clovislaforet/Station-telemetrique/README.md

# Station télémétrique
*Projet de station de télémétrie longue portée utilisant des modules LoRa pour transmettre des données entre un système embarqué (type avion RC) et une station sol.*



Vous trouverez ci-dessous quelques informations générales relatives au projet, mais un rapport complet et précis de celui-ci est disponible au téléchargement sous le nom "Rapport - Station télémétrique.pdf".

## État du projet
***Le prototype final du système est fonctionnel, et a été intégré avec succès à un aéromodèle !***

## Matériel
- Microcontroleurs : Arduino Nano Every et Arduino Mega 2560
- Module caméra : ESP32-S3 IA Camera
- Antennes longue portée : 2 modules LoRa SX1278 434mHz
- GPS : U-blox NEO-7M
- Capteur de température, d'humidité et de pression : BME280
- UBEC 5V 3A et convertisseur de tension DC-DC 5V-3.3V

<table align="center">
  <tr>
    <td align="center"><b>ESP32-S3 IA CAM</b></td>
    <td align="center"><b>U-blox NEO-7M</b></td>
    <td align="center"><b>BME280</b></td>
    <td align="center"><b>LoRa SX1278</b></td>
  </tr>
  <tr>
    <td align="center"></td>
    <td align="center"></td>
    <td align="center"></td>
    <td align="center"></td>
  </tr>
</table>

## Architecture
- La "station air", composée de l'Arduino Nano, du GPS, du BME280 et de l'autre module LoRa, capte les informations télémétriques des capteurs et les envoie grâce au module LoRa.
- La "station sol", composée de l'Arduino Mega et d'un module LoRa, récupère les données transmises par la station air et les affiche de manière ergonomique via un PC.
- La station air contient aussi l'ESP32 avec sa caméra, mais celui-ci est indépendant du reste : on peut ou non l'allumer, voir ne pas l'installer du tout pour gagner de l'autonomie et du poids.

## Utilisation
1. Câbler le système, et fixer au modèle RC la caméra
2. Flasher sur les deux Arduino et sur l'ESP32-S3 IA CAM leur code respectif
3. Alimenter le système, et attendre un court moment la bonne initialisation des composants
4. Exécuter le code Python sur le PC, avec la station sol branchée sur un port série
5. Observer les graphiques de télémétrie
6. Ouvrir la carte via le lien HTML généré dans le dossier de travail
7. Après le vol, récupérer la carte SD et enregistrer sur le PC le fichier contenant les images
8. Se placer dans ce fichier, y ouvrir un terminal, et lancer la commande fournie pour générer une vidéo (grâce au logiciel FFMPEG qu'il faut préalablement installer)

## Informations complémentaires
Masse totale de la station air : 234g

*À noter que cette masse est celle du prototype, incluant notamment une breadboard et de nombreux fils. Une version finale plus compacte avec PCB permettrait une masse nettement inférieure.*

## Exemples
<table align="center">
  <tr>
    <td align="center"><b>Prototype (avec breadboard)</b></td>
    <td align="center"><b>Exemple d'intégration sur avion RC</b></td>
  </tr>
  <tr>
    <td align="center"></td>
    <td align="center"></td>
  </tr>
  <tr>
    <td align="center"><b>Exemple de visualisation sur la carte</b></td>
    <td align="center"><b>Exemple de graphiques des informations télémétriques</b></td>
  </tr>
    <tr>
    <td align="center"></td>
    <td align="center"></td>
  </tr>
</table>

## Licence
MIT License
