clovislaforet/Station-telemetrique/Rapport _ Station télémétrique.pdf

## Rapport Défi Développement Durable

## Spécialité Électronique et Télécommunications

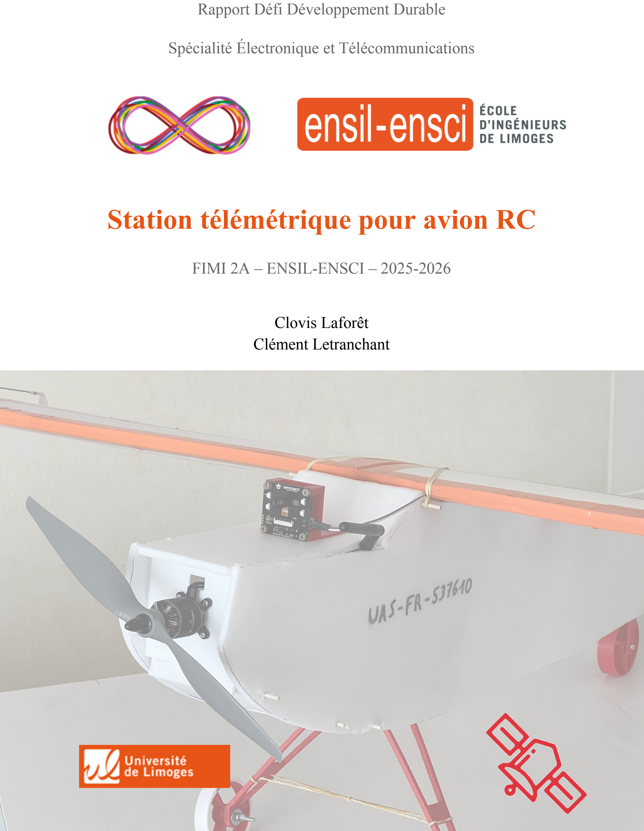
[picture p1: page 1]

# Station télémétrique pour avion RC

## FIMI 2A – ENSIL-ENSCI – 2025-2026

## Clovis Laforêt Clément Letranchant

Clovis Laforêt – Clément Letranchant

# I. Sommaire

Page 2 sur 18

# II. Introduction

Étant en possession d’un avion RC télécommandé dépourvu de capteurs de vol, nous nous sommes intéressés à la possibilité de créer par nous-même cette “station télémétrique”.

En effet, l’objectif du projet est d’ajouter à un modèle RC un groupe de capteurs, dont les données récoltées sont transmises au télépilote au sol. Nous avons déterminé que les informations les plus importantes et intéressantes à apporter à cet avion sont la température, la pression, l’humidité, l’altitude, et la position GPS. Elles permettent d’avoir un suivi qualitatif quant au déroulement du vol. De plus, il est intéressant pour un télépilote d’avoir un retour vidéo, c’est pourquoi une caméra embarquée complète le projet.

En permettant la collecte de données atmosphériques ainsi que le suivi géographique précis d’un aéronef léger, cette station télémétrique constitue un outil d’analyse pouvant être utilisé pour étudier des phénomènes locaux. Ce type de dispositif permettrait de réaliser des relevés à moindre coût et avec un impact environnemental limité, notamment en comparaison avec des moyens d’observation plus lourds et énergivores.

Ainsi, à travers ce rapport, vous découvrirez notre cheminement de pensée, les obstacles rencontrés, et les solutions apportées, afin d’avoir un retour complet sur ce que nous avons imaginé pour atteindre notre objectif :

Concevoir une solution autonome capable de capturer des données environnementales, de transmettre sa position géographique en temps réel à une station au sol via une liaison longue portée, et de filmer et enregistrer des images pour une exploitation vidéo post-vol.

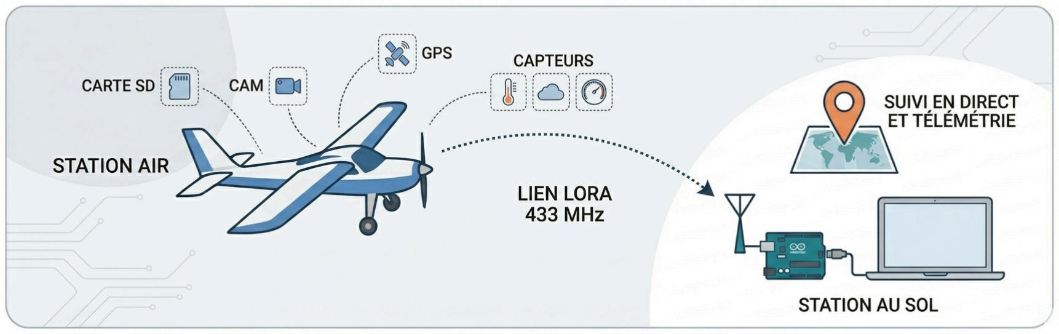
[picture p2: figure]

Page 3 sur 18

# III. Architecture matérielle

## 1. Unités de contrôle : Arduino Nano Every et Arduino Mega 2560

Le système repose sur une Arduino Nano Every et une Arduino Mega 2560. Ces cartes ont été retenues pour leur importante documentation, leur facilité d’intégration et leur nombre suffisant d’entrées/sorties. Dans la suite du rapport, la carte Arduino Nano Every sera appelée “station air” et la carte Arduino Mega 2560 sera la “station sol”, afin de les identifier et de distinguer leurs composants/modules respectifs.

La station sol est directement reliée à un ordinateur par liaison USB. Cela permet de l’alimenter et de récolter via le port série les données transmises par la station air. La station air quant à elle, est alimentée par un UBEC 5V 3A lui-même desservi par une batterie externe portable justement dimensionnée pour le système. (Voir la partie “Énergie”.)

Vous trouverez en annexe 1 leurs schémas de pinout respectifs [1, 2], qui nous ont été utiles pour déterminer les pins disponibles pour nos composants et capteurs, ainsi que d’identifier les pins correspondants aux communications UART, I2C et SPI.

## 2. Unité de capture vidéo : ESP32-S3 IA CAM

L’unité de capture vidéo est située dans la station air, et est dédiée à l’acquisition et à l’enregistrement des images embarquées. Elle fonctionne indépendamment de l’unité de contrôle afin de ne pas perturber les performances de la télémétrie. Ce module dispose à la fois d'un microcontrôleur ESP32-S3 et d’une caméra, ce qui permet de capturer des images sans nécessiter de composants supplémentaires. De plus, un lecteur de carte microSD est disponible, permettant de stocker localement les données (figure 1).

Cependant, ce module ne permet pas une transmission vidéo longue portée dans le cadre de ce projet, ce qui justifie le choix d’un enregistrement local plutôt qu’un retour vidéo en direct. Des images sont capturées, puis enregistrées en temps réel sur la carte microSD. Une fois le vol terminé, on peut récupérer la carte, et créer une vidéo à partir des images enregistrées.

Le déclenchement de la capture et de l’enregistrement se fait en branchant le module ESP32 au 5V délivré par l’UBEC. Il faut donc que le système soit au sol pour démarrer ou éteindre l’enregistrement. Une version ultérieure du projet pourrait permettre l’allumage/l’extinction du système à distance, grâce à un relais ou un MOSFET. (Voir la partie “Améliorations envisageables”.)

Ainsi, dans ce projet, l’ESP32 assure la capture d’images embarquées, l’enregistrement de ces images sur la carte microSD, et un fonctionnement autonome une fois alimenté.

Page 4 sur 18

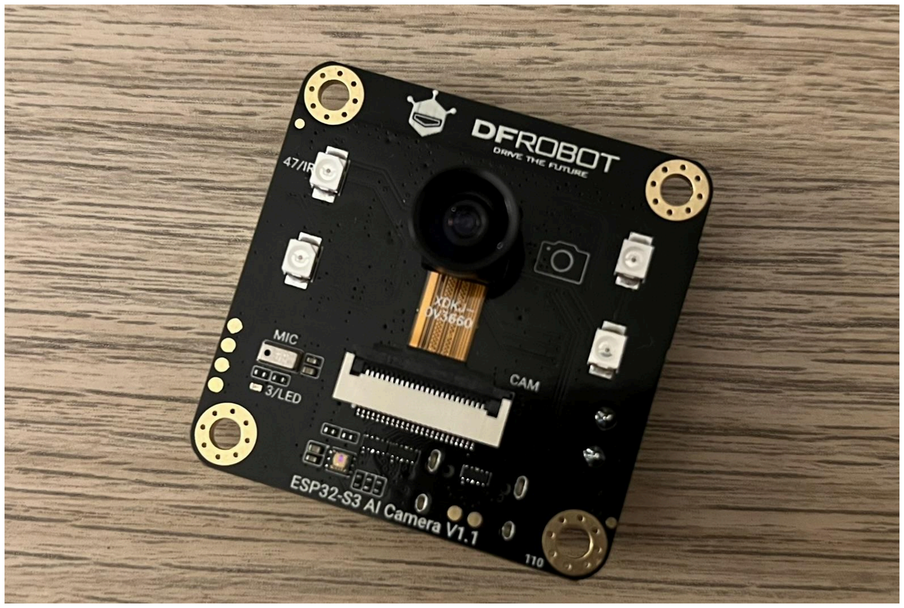
[picture p3: figure]
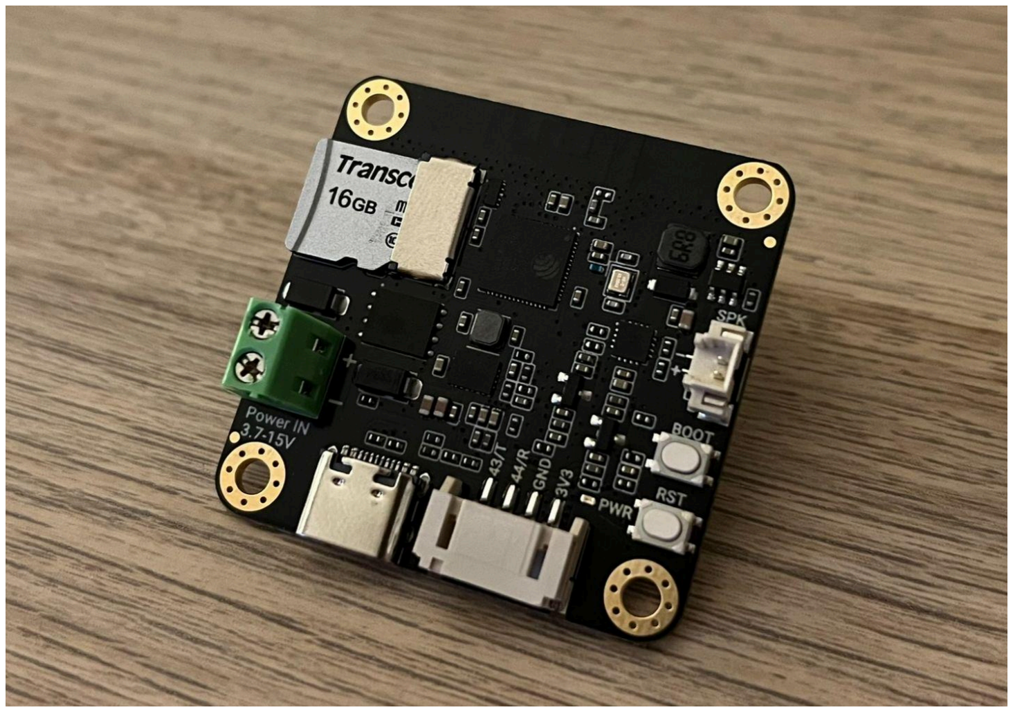
[picture p4: figure]

Figure 1 : ESP32-S3 IA CAM DFRobot [3] (faces avant et arrière)

## 3. Capteur de température, d’humidité et de pression : BME280

Dans ce projet, le BME280 est utilisé afin d’acquérir la température, la pression atmosphérique et l’humidité. Le choix de ce capteur repose en particulier sur sa compacité et sa très faible masse, mais aussi sur sa capacité à regrouper plusieurs mesures au sein d’un seul composant et sa faible consommation énergétique (figure 2).

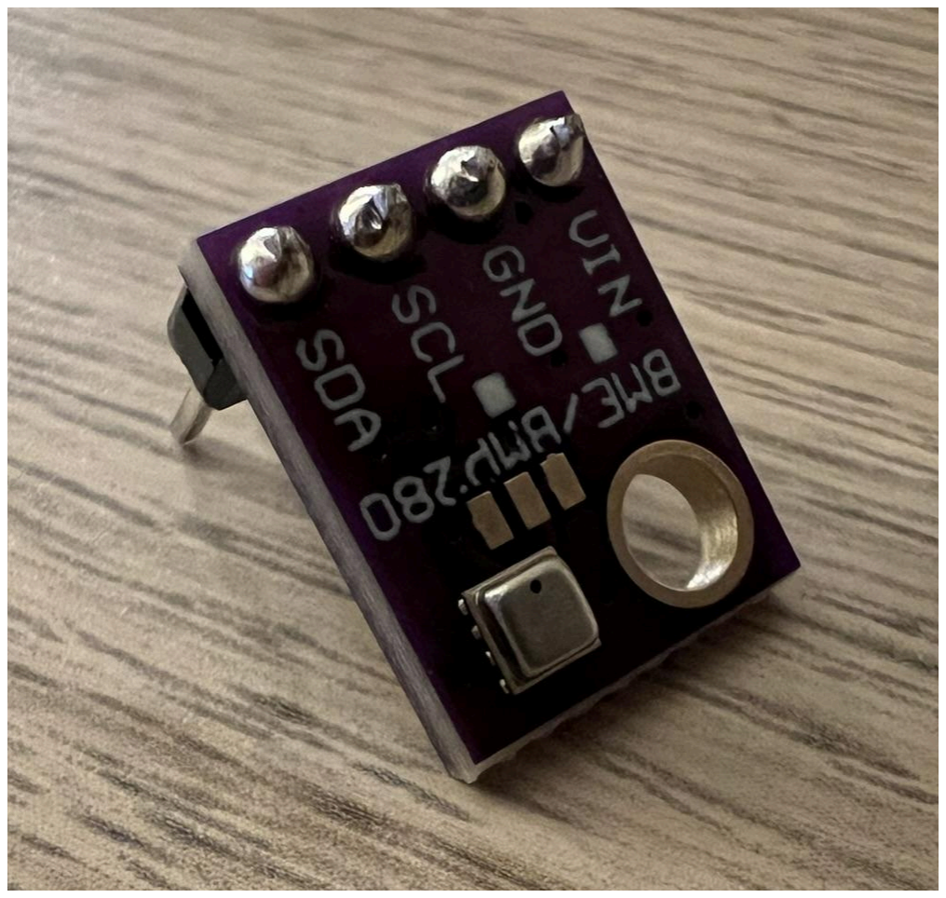
[picture p5: figure]

Grâce à la mesure de la pression atmosphérique, on peut
déterminer l’altitude du modèle RC à l’aide d’une relation
barométrique. Cette information vient compléter les données fournies par le module GPS. Cependant, cette mesure dépend des conditions météorologiques et n’est donc pas très précise, c’est plus une estimation qu’une mesure directe. En revanche une variation d’altitude (de part une variation de pression), peut être précisément mesurée grâce à ce module.

Ainsi, dans ce projet, le capteur BME280 assure la mesure de la température, la mesure de l’humidité, la mesure de la pression atmosphérique, ainsi qu’une estimation de l’altitude.

## 4. Module GPS : U-blox NEO-7M

Le module GPS est utilisé afin de déterminer la position géographique du modèle en temps réel. Dans ce projet, un module U-blox NEO-7M (figure 3) est intégré à la station air pour fournir les coordonnées de latitude et de longitude uniquement : l’altitude étant plus précise avec le BME280 qu’avec ce module.

Le choix de ce module repose sur sa compatibilité avec les cartes Arduino, sa simplicité d’utilisation et son importante documentation. Il s’agit d’un module GPS couramment utilisé dans des projets embarqués, capable de fournir des données de position de manière autonome une fois le signal satellite acquis.

Page 5 sur 18

Figure 2 : BME280

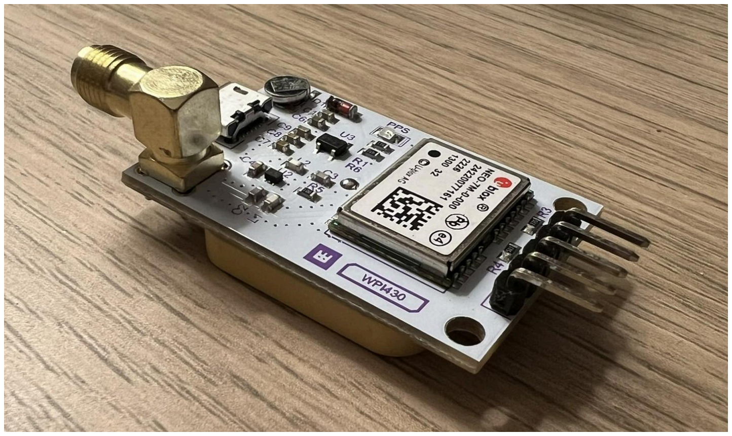
[picture p6: figure]

Lors de sa mise sous tension, un temps d’initialisation est nécessaire afin d’obtenir suffisamment de satellites pour des positions fiables. Ceci dépend des conditions de réception, mais prend pour l’ensemble de nos tests entre 1 et 3 min. De plus, la précision des mesures peut être affectée par l’environnement (obstacles, conditions météorologiques). On ne peut notamment pas utiliser ce GPS en intérieur à cause du signal satellite trop faible.

Ainsi, dans ce projet, le module GPS assure la mesure de la latitude et de la longitude.

## 5. Communication longue portée : LoRa SX1278

La communication entre la station air et la station sol est assurée par une liaison longue portée basée sur la technologie LoRa (figure 4). Contrairement à d’autres technologies sans fil comme le Wi-Fi ou les modules NRF24L01, la modulation LoRa est spécifiquement conçue pour des applications à faible débit nécessitant une grande portée, ce qui correspond parfaitement aux contraintes de notre projet. Vous trouverez le pinout de ce module en figure 5.

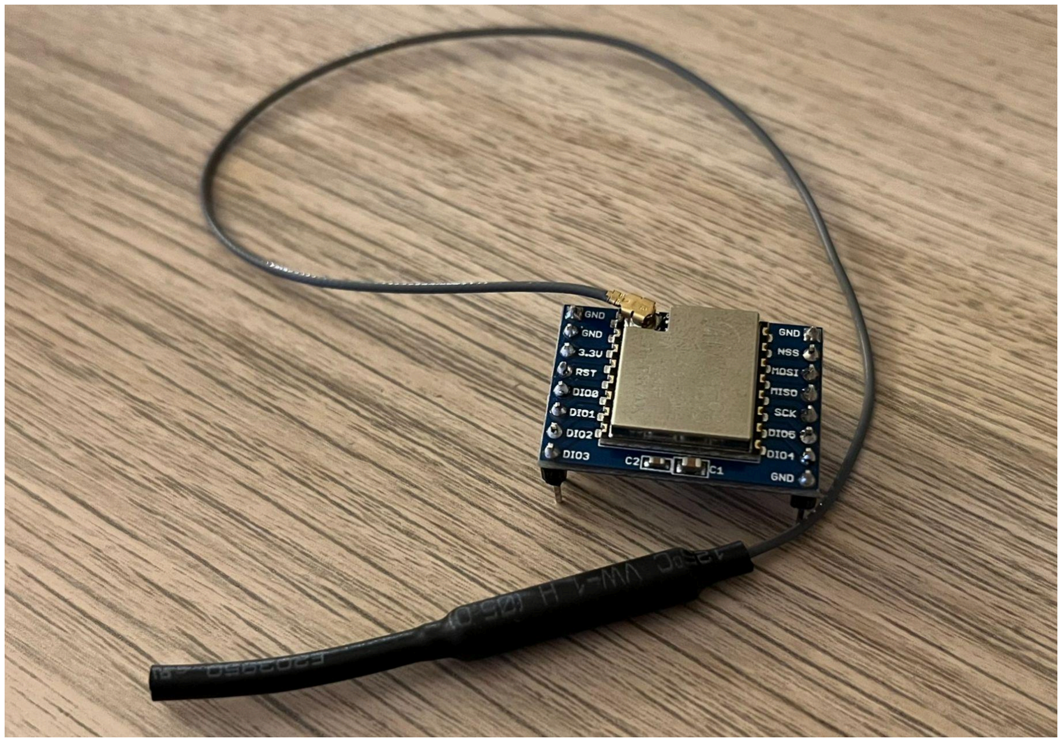
[picture p7: figure]
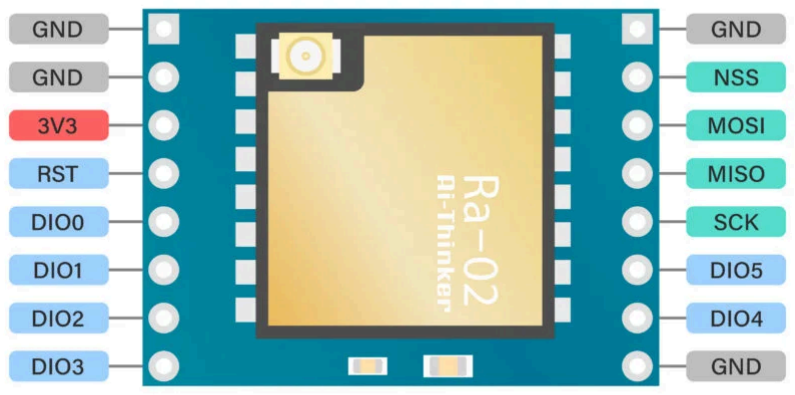
[picture p8: figure]

Figure 4 : Module LoRa SX1278 | Figure 5 : Pinout LoRa SX1278 [4]

Dans ce système, la station air envoie périodiquement les données issues des capteurs (température, pression, humidité, altitude et position GPS), tandis que la station sol reçoit ces informations et les transmet à un ordinateur. Cependant, cette technologie ne permet pas l’envoi de données volumineuses comme un flux vidéo. Ceci impose donc une séparation entre la télémétrie et la vidéo, enregistrée localement sur l’ESP32.

L’utilisation de la bande de fréquence 433 MHz permet d’éviter les interférences avec la radiocommande de l’avion, opérant en 2,4 GHz, tout en respectant les bandes de fréquence autorisées en Europe. (Voir la partie “Sécurité et contraintes”.)

Page 6 sur 18

Figure 3 : U-blox NEO-7M

## 6. Énergie

### a) Dimensionnement énergétique

La station air est alimentée par une batterie externe Li-ion 7.4V, associée à un module UBEC délivrant une tension régulée de 5V. Ce choix permet d’assurer une alimentation stable pour l’ensemble des composants. On dispose aussi d’un convertisseur de tension DC-DC 5V-3.3V pour les composants qui ont besoin d’une plus basse tension.

Afin de vérifier le bon dimensionnement de l’alimentation, nous avons réalisé une estimation des courants consommés par chaque composant :

Composants | Courant maximum (pics de courant) | Tension délivrée | Puissance
Arduino Nano Every | 50 mA [5] | 5 V | 0.25 W
ESP32-S3 IA CAM | 200 mA [6] | 5 V | 1 W
U-blox NEO-7M | 50 mA [7] | 5 V | 0.25 W
LoRa SX1278 | 120 mA (émission) [8] | 3.3 V | 0.396 W
BME 280 | 5 mA [9] | 3.3 V | 0.0165 W
Total : | 425 mA | | 1.9125 W

Avec une marge de sécurité, on estime alors un courant total maximum de 500 mA. Cette valeur reste bien inférieure à la capacité maximale de l’UBEC de 3 A, garantissant un fonctionnement fiable du système, pour une puissance consommée inférieure à 2 W.

### b) Autonomie

L’autonomie du système dépend de la capacité de la batterie utilisée et du courant consommé. Ici, nous utilisons une batterie Li-ion de capacité 3000 mAh. On peut alors estimer l’autonomie :

En pratique, il est nécessaire de prendre en compte la décharge partielle de la batterie, les pertes énergétiques et son vieillissement. L’autonomie est ainsi estimée à environ 5h, valeur largement supérieure à la durée de vol d’un avion RC (2 à 30 minutes) et largement surévaluée à la baisse pour plus de sécurité.

Page 7 sur 18

# IV. Station sol

## 1. Retour des coordonnées GPS

La station sol reçoit via LoRa les données transmises par la station air. Ces informations sont décodées par l’Arduino puis envoyées vers un ordinateur via une liaison série USB, où un programme Python les lit en temps réel. Celui-ci utilise des expressions régulières pour détecter et extraire les valeurs des coordonnées, qui sont ensuite stockées afin de reconstituer le trajet du modèle.

La visualisation est réalisée à l’aide de la bibliothèque “Folium”, qui permet de générer une carte basée sur des données cartographiques (OpenStreetMap). Le résultat est exporté sous forme d’un fichier HTML, ouvrable dans un navigateur web. À chaque nouvelle position reçue : un point est ajouté sur la carte ; le trajet est tracé sous forme de lignes reliant les différentes positions.

Pour visualiser cette représentation en temps réel et les différentes positions du modèle RC, il suffit d’actualiser la page. Il faut cependant noter que la précision dépend des coordonnées envoyées par le module GPS, et que celles-ci peuvent varier de manière incohérente selon l’environnement et les satellites disponibles.

Ci-dessous figure 6, un exemple de visualisation que l’on obtient. Le point vert correspond aux premières coordonnées reçues ; le point rouge, les dernières. On peut voir que le chemin parcouru est retracé.

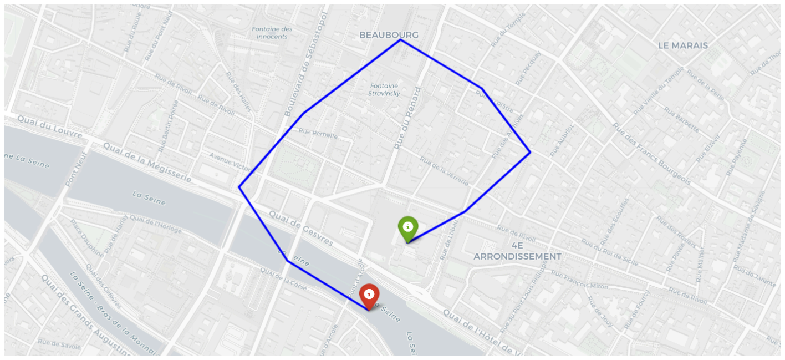
[picture p9: figure]

Figure 6 : Exemple de visualisation obtenue

## 2. Retour des informations télémétriques

Les informations télémétriques sont récupérées de la même manière que les coordonnées GPS : une expression régulière détecte le mot-clé correspondant et extrait le nombre situé en fin de ligne. Ce nombre est alors stocké dans une variable dédiée. Lorsque les cinq variables (température, humidité, pression, altitude, RSSI) sont toutes remplies, les valeurs sont écrites dans un fichier CSV (figure 7).

Page 8 sur 18

À chaque nouveau paquet enregistré, le script relit l'intégralité du fichier CSV et génère quatre graphiques qui sont affichés simultanément dans une fenêtre Spyder : température, humidité, RSSI, et un graphique combinant pression/altitude. Les axes sont ajustés automatiquement autour des valeurs réelles pour éviter une lecture trompeuse des variations (figure 8).

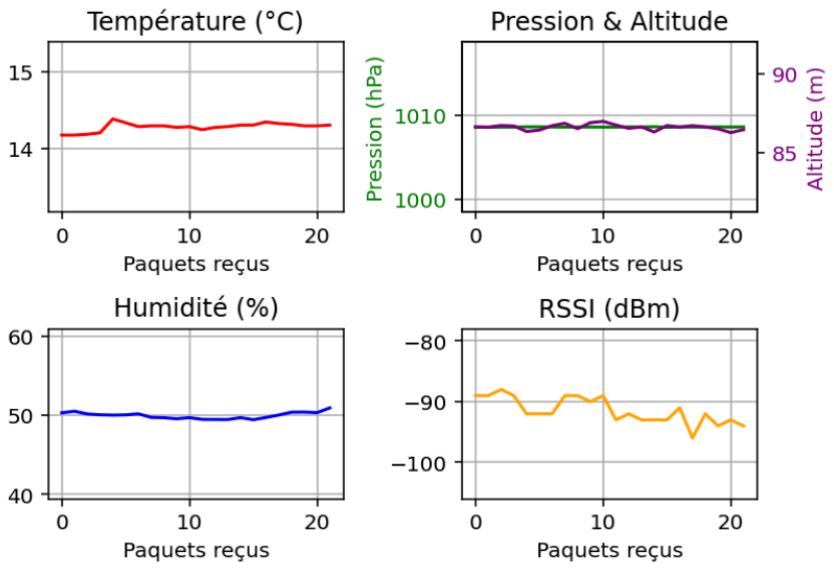
[picture p10: figure]
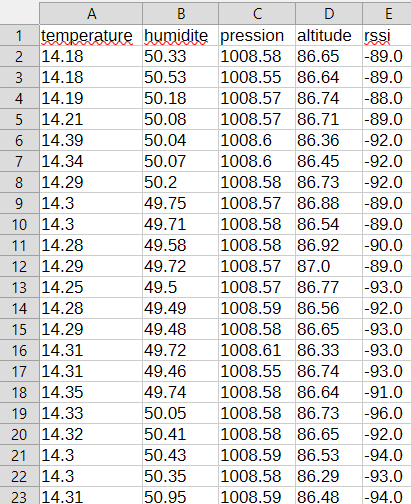
[picture p11: figure]

Figure 7 : Fichier CSV obtenu | Figure 8 : Graphiques obtenus

## 3. Exploitation vidéo post-vol

À l’issue du vol, la carte microSD est extraite du module afin de récupérer les images enregistrées. Celles-ci sont sauvegardées sous forme de fichiers individuels (img_0.jpg, img_1.jpg, img_2.jpg, …), correspondant à une acquisition au cours du temps. Afin de reconstruire une vidéo à partir de ces images, un outil de traitement vidéo est utilisé. Dans ce projet, le logiciel FFmpeg est employé. Après avoir ouvert un terminal dans le dossier contenant les images, la commande suivante est exécutée :

ffmpeg -framerate 10 -i img_%d.jpg -c:v libx264 -pix_fmt yuv420p video.mp4

Cette commande permet d’assembler les images en une séquence vidéo au format mp4, avec une fréquence de 10 images par seconde. Le fichier obtenu peut ensuite être lu sur un ordinateur afin de visualiser le vol.

Par un compromis entre qualité et vitesse d’enregistrement, nous avons décidé de dimensionner les images en SVGA (800x600) : un format d’une qualité suffisamment importante pour correctement distinguer l’environnement, mais suffisamment faible pour laisser le temps à l’ESP32 d’enregistrer l’image sur la carte avant d’en obtenir une nouvelle.

Page 9 sur 18

# V. Câblage et Programmation

Chaque module utilise un protocole de communication différent afin d’optimiser les performances. Le nombre limité de broches de l’Arduino Nano impose de réduire les connexions pour garantir un système fiable. De plus, selon le microcontrôleur utilisé, les modules/composants ne se branchent pas de la même manière, et il peut même être nécessaire de spécifier au programme les emplacements choisis suivant la carte utilisée. C’est le cas notamment pour le module air, lors de l’association Arduino Nano Every et LoRa SX1278.

Vous trouverez en annexe 2 des photographies de la première version du système. Ce prototype fonctionnel est câblé sur une breadboard, ce qui facilite les phases de développement et de test. Dans une version finale, la réalisation d’un circuit imprimé (PCB) permettrait de réduire l’encombrement et la masse de la station air en particulier (actuellement de 234g), tout en améliorant la fiabilité du câblage et la qualité de l’intégration.

La figure 9 rappelle les flux de données de chaque composant du système, notamment les modules LoRa communiquent avec Arduino via le protocole SPI [10]. Voici ci-dessous le pinout associé.

LoRa SX1278 | Arduino Nano Every (module air) | Arduino Mega 2560 (module sol)
3.3V | 3.3V | 3.3V
GND | GND | GND
RST | D9 | D9
DIO0 | D2 | D2
NSS | D8 | D53
MOSI | D11 | D51
MISO | D12 | D50
SCK | D13 | D52

Le module GPS U-blox NEO-7M communique avec l’Arduino via le protocole UART [11] et le module BME280 communique via le protocole I²C [12]. Voici ci-dessous les pinouts associés :

BME280 | U-blox NEO-7M | Arduino Nano Every (module air)
| VCC | 5V
VCC | | 3.3V
GND | GND | GND
| TXD | D4 (RX)
| RXD | D3 (TX)
SCL | | A5
SDA | | A4

Page 10 sur 18

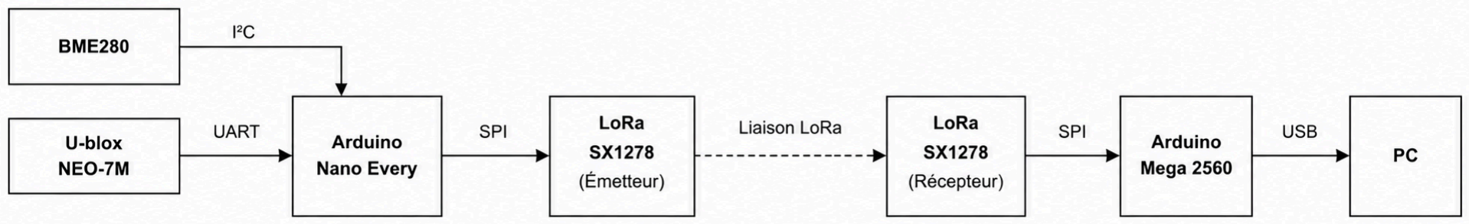
[picture p12: figure]

Figure 9 : Diagramme de flux de données

## 1. LED d’état

Ont été ajoutées 3 LED d’état dans la station air. La verte s’allume une fois que tous les composants ont démarré correctement, et clignote une fois pour chaque composant correctement initialisé. Celle-ci est branchée sur le pin D5. La blanche ne s’allume que lors de l’initialisation des composants afin de signifier le bon démarrage du système, elle est branchée sur le pin D7. Enfin, la rouge ne s’allume que lorsque l’initialisation de l’un des composants a échoué, elle est branchée sur le pin D6. Toutes les LED sont en série avec une résistance de 330Ω.

Ce code couleur nous a permis d’identifier plus facilement et rapidement les problèmes lorsque nous en rencontrions lors du développement, mais il informe maintenant surtout l’utilisateur du bon démarrage et du bon fonctionnement du système.

## 2. Distribution de l’énergie

Comme vu précédemment, on dispose d’un UBEC 5V 3A pour réguler la tension. Celui-ci, positionné en parallèle de la batterie, fournit l’énergie à l’ESP32 et à un convertisseur de tension DC-DC 5V-3.3V. On utilise ici une breadboard, dont un rail fournit le 5V de l’UBEC et l’autre rail le 3.3V du convertisseur de tension. On peut alors brancher le Vin de l’Arduino Nano sur le rail 5V, chaque composant sur le rail correspondant, et connecter les GND ensembles.

Vous trouverez en annexe 3 le schéma de câblage de la station air, réalisé avec KiCad. À noter que ce schéma privilégie une représentation proche du câblage réel afin de faciliter la compréhension du montage. Il permet une visualisation d'ensemble propre et complète.

## 3. Programmation

L’ensemble des codes sources développés dans le cadre de ce projet est disponible à la consultation et la réutilisation sur GitHub, dont le lien est fourni en annexe 4.

De plus, en annexe 5 sont disponibles les logigrammes de chacun de ces codes, afin de suivre la logique de programmation.

Page 11 sur 18

# VI. Informations complémentaires

## 1. Sécurité et contraintes

### a) Fréquences

L’utilisation de modules LoRa impose le respect des réglementations en vigueur concernant les bandes de fréquence radio. En Europe, ces dispositifs peuvent opérer dans plusieurs bandes ISM, notamment autour de 433 MHz et 868 MHz, sous certaines conditions [13].

Dans le cadre de ce projet, ces contraintes sont respectées en limitant la fréquence d’émission des données télémétriques et en utilisant des puissances adaptées. De plus, le choix de la bande 433 MHz permet d’éviter les interférences avec la radiocommande de l’avion, fonctionnant en 2,4 GHz.

### b) Communication LoRa coupée

Dans le cas où la communication entre les deux modules LoRa serait coupée (à cause d’une batterie vide, ou d’un reset de la carte Arduino par exemple), la station sol ne reçoit plus les données télémétriques. Mais cela n'impacte en rien le bon fonctionnement de l’avion RC, et donc la sécurité des personnes alentour.

## 2. Améliorations envisageables

Plusieurs améliorations techniques peuvent être envisagées afin d’augmenter les performances, l’ergonomie et l’autonomie du système.

Tout d’abord, une évolution importante consisterait à permettre le contrôle à distance de l’unité de capture vidéo. Actuellement, l’ESP32 est alimenté manuellement avant le vol. L’intégration d’un dispositif de commutation électronique, tel qu’un MOSFET ou un relais piloté par l’Arduino, permettrait d’allumer ou d’éteindre la caméra à distance via la liaison LoRa. Cela offrirait une meilleure gestion de l’énergie en évitant de filmer en continu, et permettrait d’adapter l’enregistrement aux phases de vol pertinentes.

Ensuite, la qualité des images capturées pourrait être améliorée par l’ajout d’un système de stabilisation. Il serait intéressant d’intégrer un capteur inertiel (gyroscope par exemple) qui permettrait de mesurer les mouvements de l’appareil et, à terme, de compenser les vibrations soit mécaniquement (via un support stabilisé), soit numériquement en post-traitement. Ce capteur pourrait également être exploité pour d’autres fonctions, comme l’analyse du comportement en vol ou l’estimation de l’inclinaison du modèle RC.

Page 12 sur 18

# VII.Conclusion

Ce projet, bien que réalisé à une échelle expérimentale, met en évidence l’intérêt des systèmes embarqués pour la collecte et la transmission de données environnementales. L’utilisation de technologies sobres en énergie et adaptées aux longues distances illustre une approche compatible avec les enjeux du développement durable.

À terme, ce type de système pourrait servir à des applications concrètes telles que la surveillance environnementale ou l’analyse de conditions atmosphériques locales, contribuant ainsi à une meilleure compréhension de notre environnement par une méthode plus neutre pour la planète.

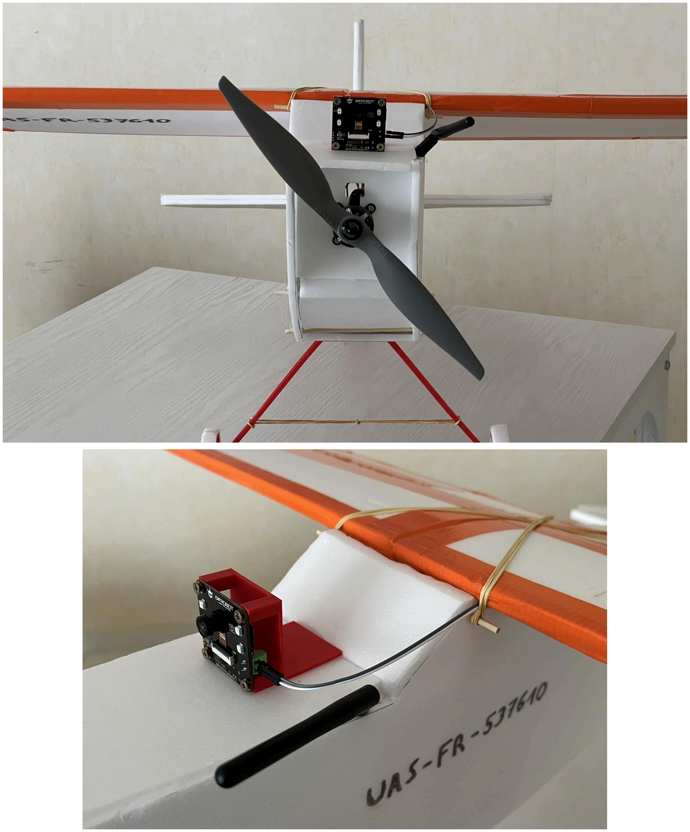
[picture p13: figure]

Figure 10 : Intégration de la station télémétrique sur un modèle RC

Page 13 sur 18

# VIII. Bibliographie

1. Arduino. Arduino Nano Every Pinout diagram. Document technique.
Disponible sur : https://docs.arduino.cc/resources/pinouts/ABX00028-full-pinout.pdf. Consulté en mars 2026.
2. Arduino. Arduino Mega 2560 Pinout diagram. Document technique.
Disponible sur : https://docs.arduino.cc/resources/pinouts/A000067-full-pinout.pdf. Consulté en mars 2026.
3. DFRobot. Gravity: ESP32-S3 AI Camera Module – Documentation technique. Disponible sur : https://wiki.dfrobot.com/dfr1154/.
Consulté en mars 2026.
4. ADIY. LoRa Module RA-02 SX1278 Module. Image produit.
Disponible sur : https://adiy.in/shop/lora-module-ra-02-sx1278-module/. Consulté en avril 2026.
5. Arduino. Arduino Nano Every – Technical Specifications.
Disponible sur : https://docs.arduino.cc/hardware/nano/.
Consulté en avril 2026.
6. Espressif Systems. ESP32-S3 – Datasheet.
Disponible sur : https://documentation.espressif.com/esp32-s3_datasheet_en.pdf. Consulté en avril 2026.
7. u-blox. NEO-7M – Data Sheet.
Disponible sur :
https://content.u-blox.com/sites/default/files/products/documents/NEO-7_DataSheet_%28UBX-13003 830%29.pdf. (https://content.u-blox.com/sites/default/files/products/documents/NEO-7_DataSheet_%28UBX-13003830%29.pdf)
Consulté en avril 2026.
8. Semtech. SX1278 – LoRa Transceiver Datasheet.
Disponible sur : https://www.semtech.com/products/wireless-rf/lora-connect/sx1278. Consulté en avril 2026.
9. Bosch Sensortec. BME280 – Environmental Sensor Datasheet.
Disponible sur :
https://www.bosch-sensortec.com/media/boschsensortec/downloads/datasheets/bst-bme280-ds002.pdf. Consulté en avril 2026.
10. Circuit Basics. Basics of the SPI Communication Protocol.
Disponible sur : https://www.circuitbasics.com/basics-of-the-spi-communication-protocol/
Consulté en mai 2026.
11. Arduino Documentation. Unlocking the Power of UART: A Guide to Asynchronous Communication. Disponible sur : https://docs.arduino.cc/learn/communication/uart/
Consulté en mai 2026.
12. Circuit Basics. Basics of the I2C Communication Protocol.
Disponible sur : https://www.circuitbasics.com/basics-of-the-i2c-communication-protocol/ Consulté en mai 2026.
13. AFNOR. ETSI NF EN 300220 – équipements radio courte portée.
Norme européenne.
Consulté en mars 2026.

Page 14 sur 18

# IX. Annexes

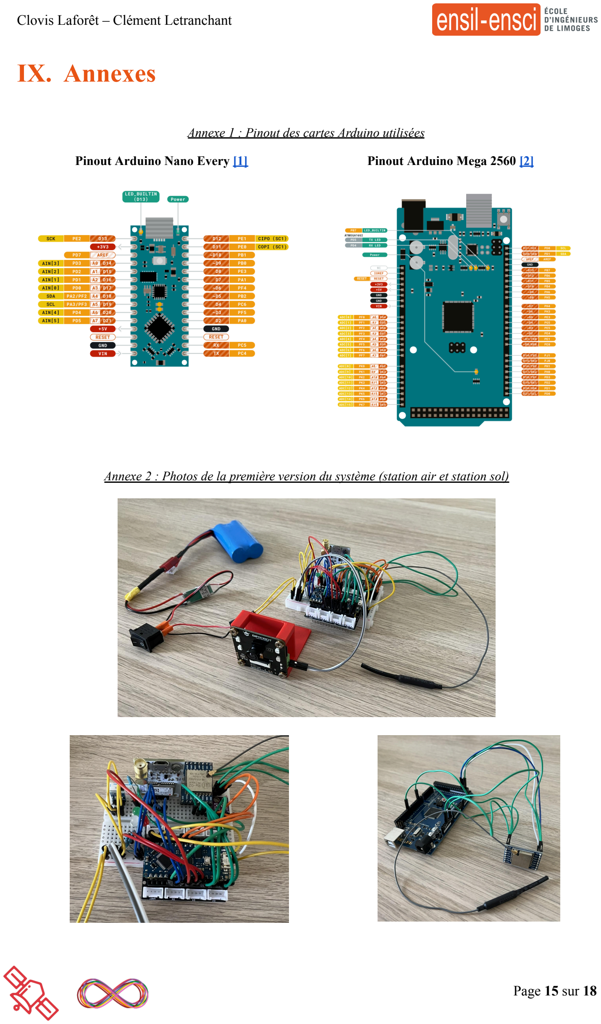
[picture p14: page 15]

Annexe 1 : Pinout des cartes Arduino utilisées

Pinout Arduino Nano Every [1] | Pinout Arduino Mega 2560 [2]

Annexe 2 : Photos de la première version du système (station air et station sol)

Page 15 sur 18

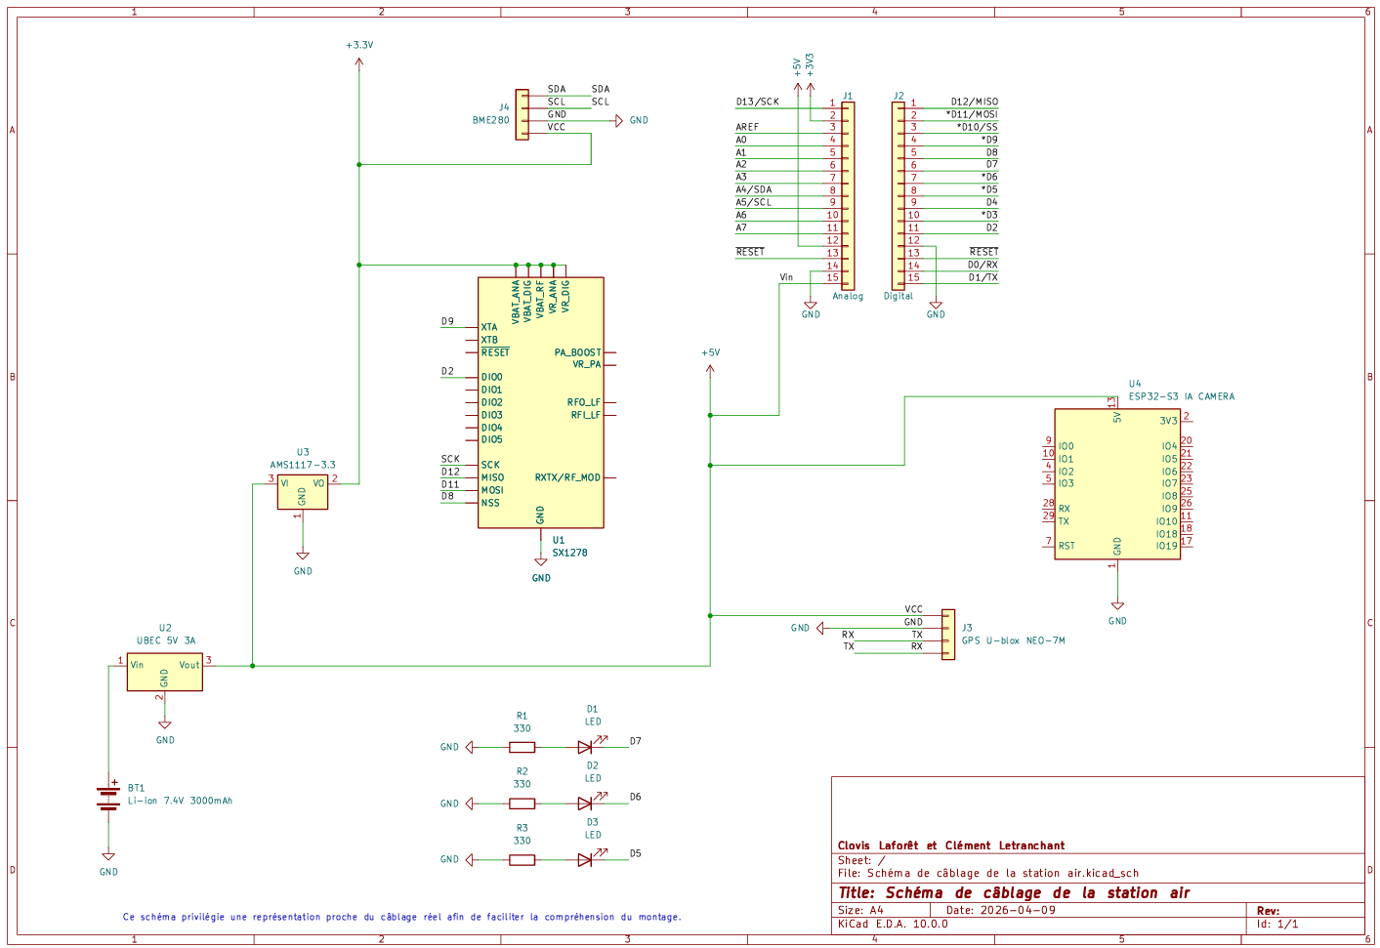
[picture p15: figure]

Annexe 3 : Schéma de câblage de la station air

Page 16 sur 18

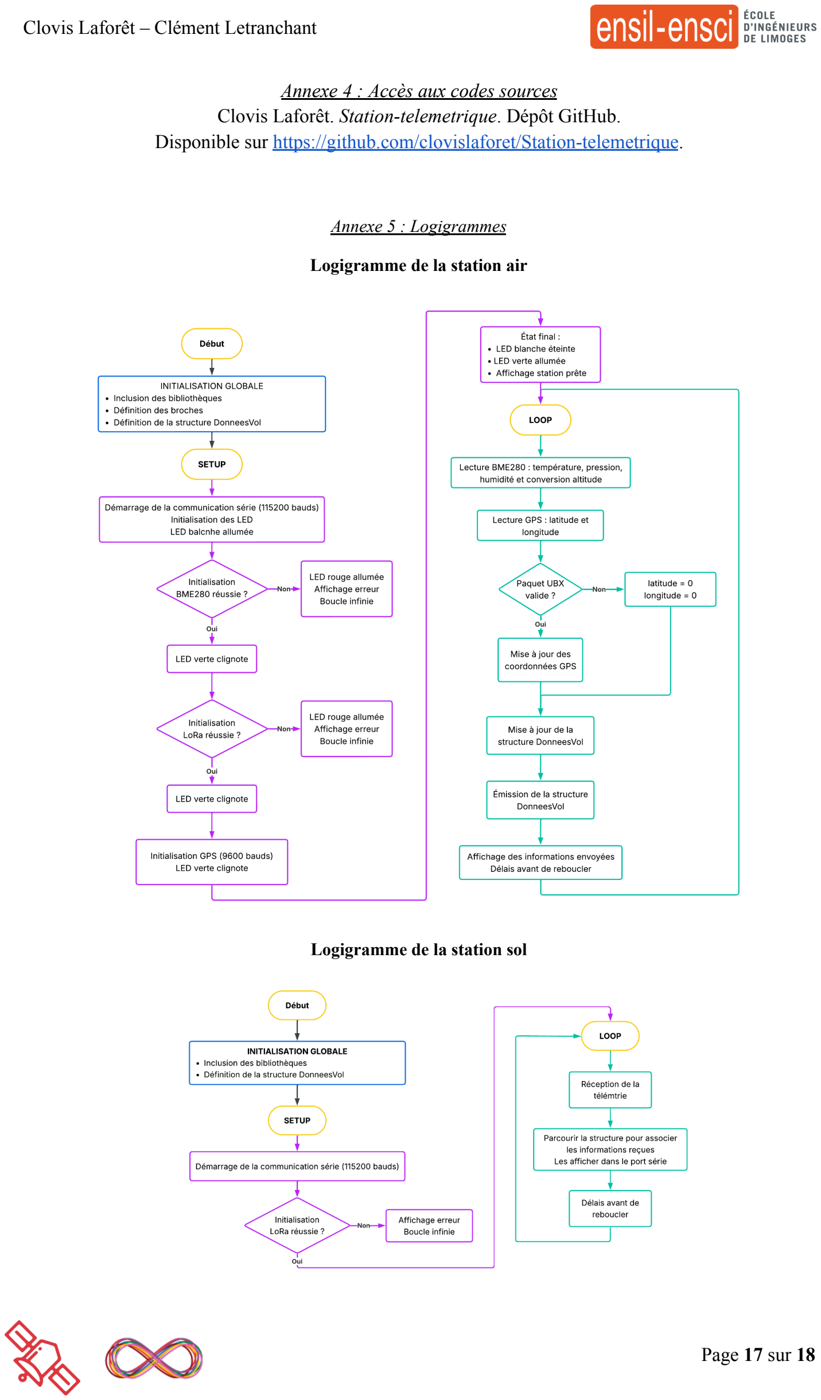
[picture p16: page 17]

Annexe 4 : Accès aux codes sources Clovis Laforêt. Station-telemetrique. Dépôt GitHub. Disponible sur https://github.com/clovislaforet/Station-telemetrique.

Annexe 5 : Logigrammes

Logigramme de la station air

Logigramme de la station sol

Page 17 sur 18

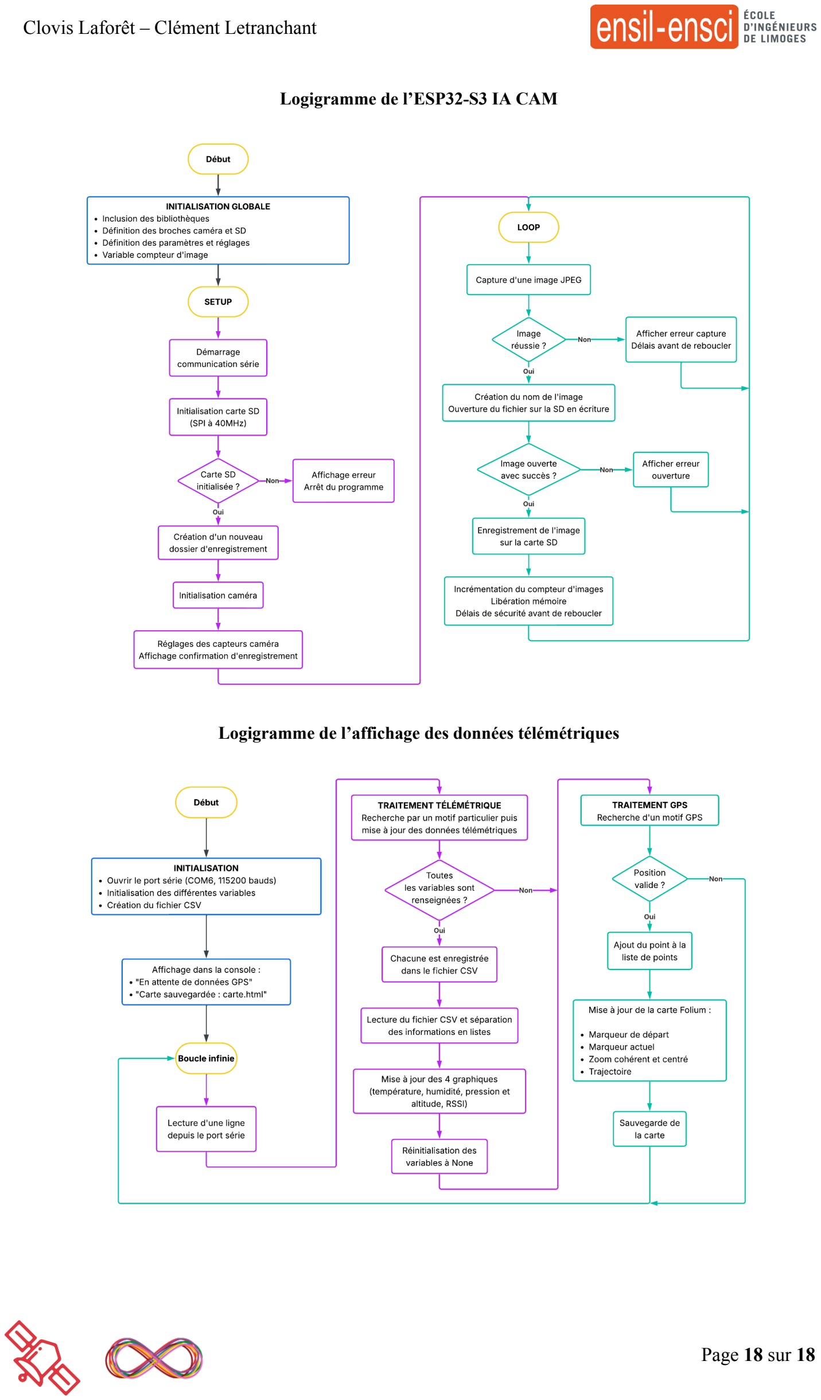
[picture p17: page 18]

Logigramme de l’ESP32-S3 IA CAM

Logigramme de l’affichage des données télémétriques

Page 18 sur 18
