clovislaforet/Station-telemetrique/ESP32S3_IA_CAM/Support caméra.3mf

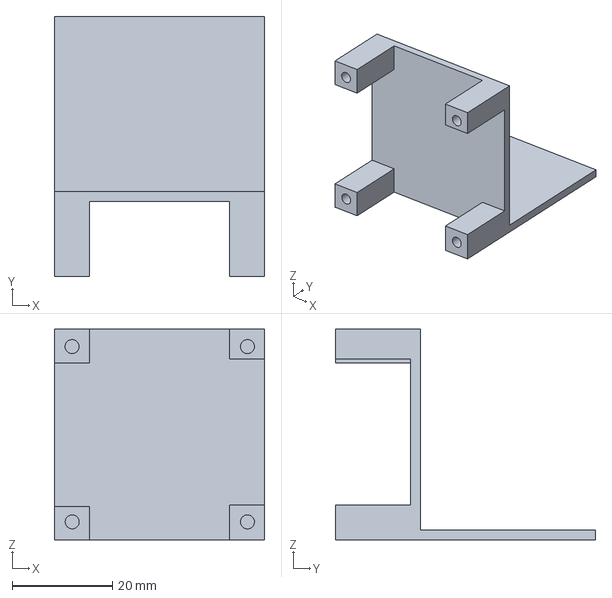
[picture p18: CAD file, 2026-05-03]
ESP32S3_IA_CAM/Support caméra.3mf
41.9 x 52.0 x 42.1 mm
