clovislaforet/Station-telemetrique/(list of files, cad)

Other CAD files:
ESP32S3_IA_CAM/Support caméra.STL
